mprosk/gameport/README.md

# GamePort to CV
KOSMO format module that converts a GamePort joystick to gate and control voltages

The X and Y movement of the stick is output as two independent control voltages ranging from 0V to +5V. The two buttons are output as gate signals, also from 0V to +5V
