mprosk/gameport/schematic.pdf

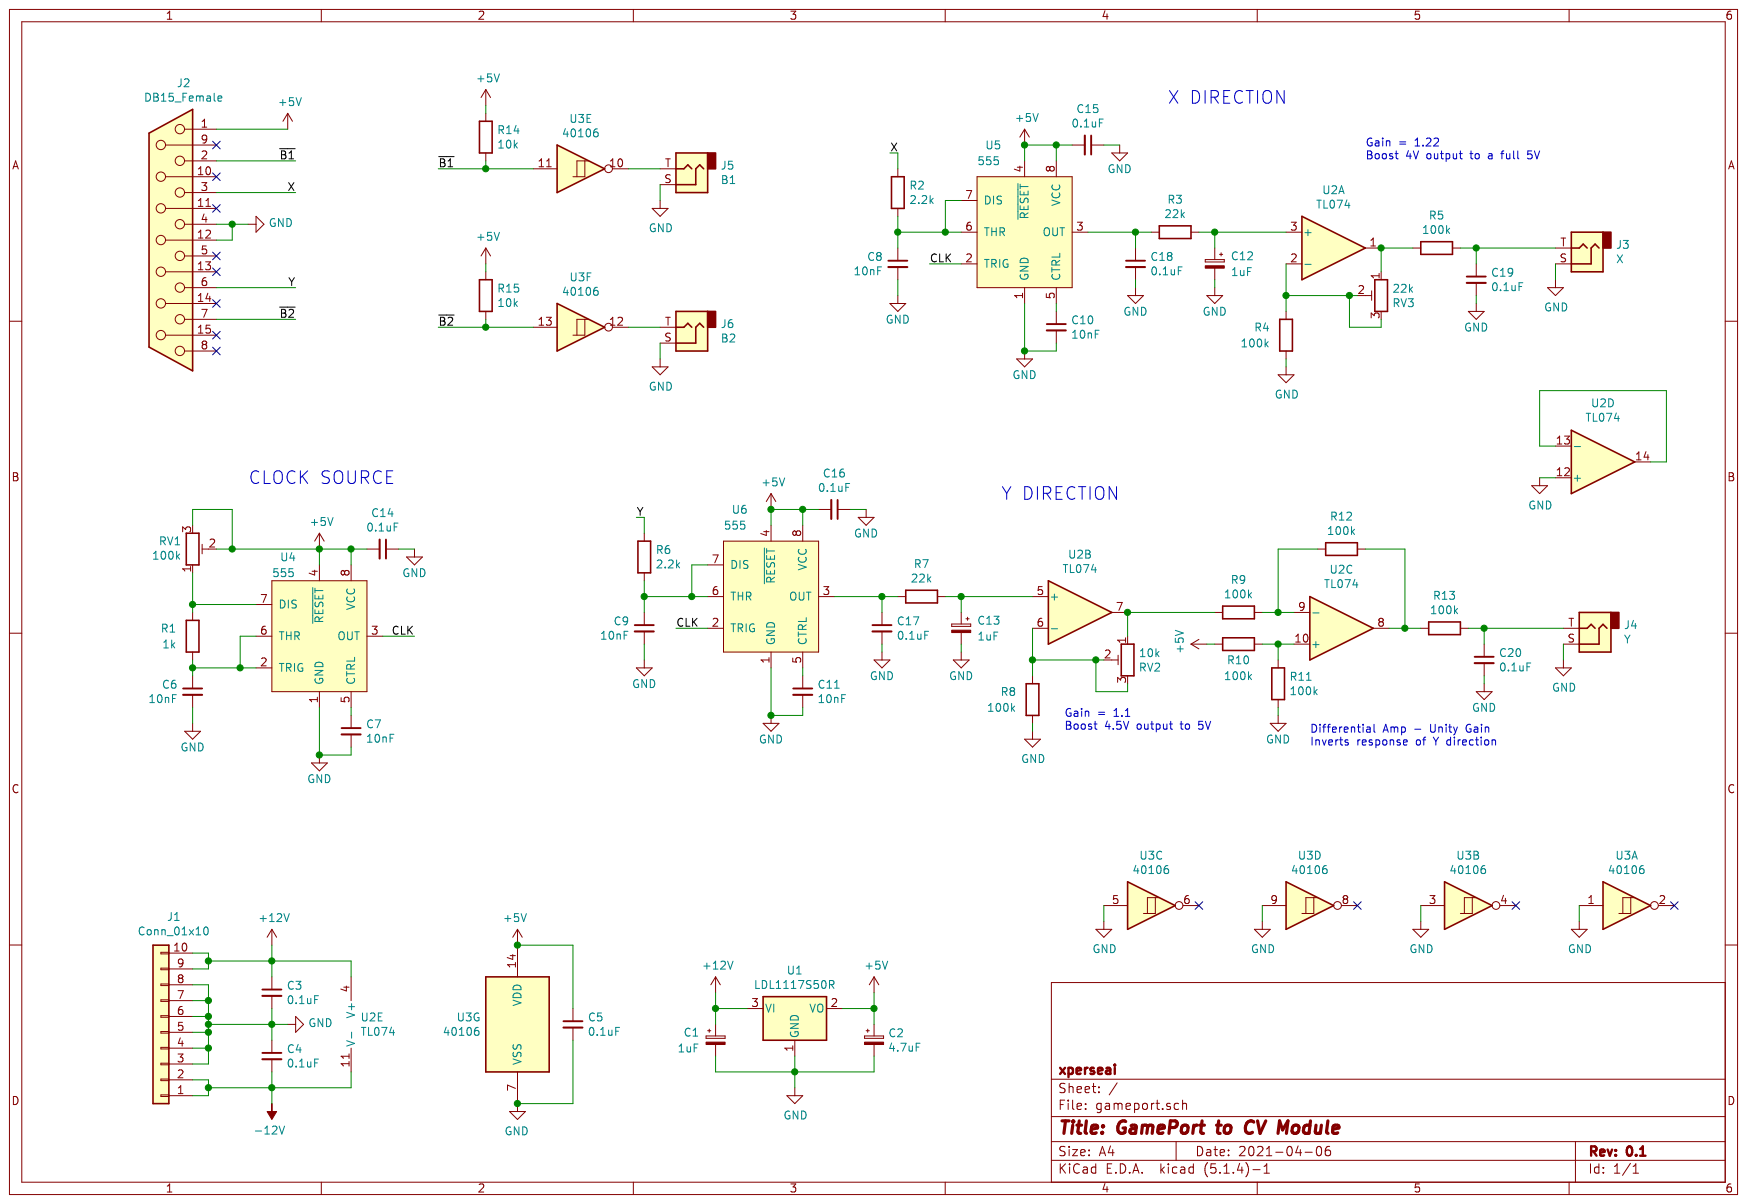
[picture p1: page 1]
