mprosk/gameport/gameport/y_axis_diff_amp.asc

R1: res; 100k
R2: res; 100k
R3: res; 100k
R4: res; 100k
U1: UniversalOpamp2
V1: voltage; 12
V2: voltage; -12
V3: voltage; 2
V4: voltage; 5
Named nets: 0, OUTPUT, INPUT
.dc V3 0 5 .1
