mprosk/gameport/gameport/gameport.kicad_pcb

## KiCad design gameport/gameport.kicad_pcb (2022-04-15)

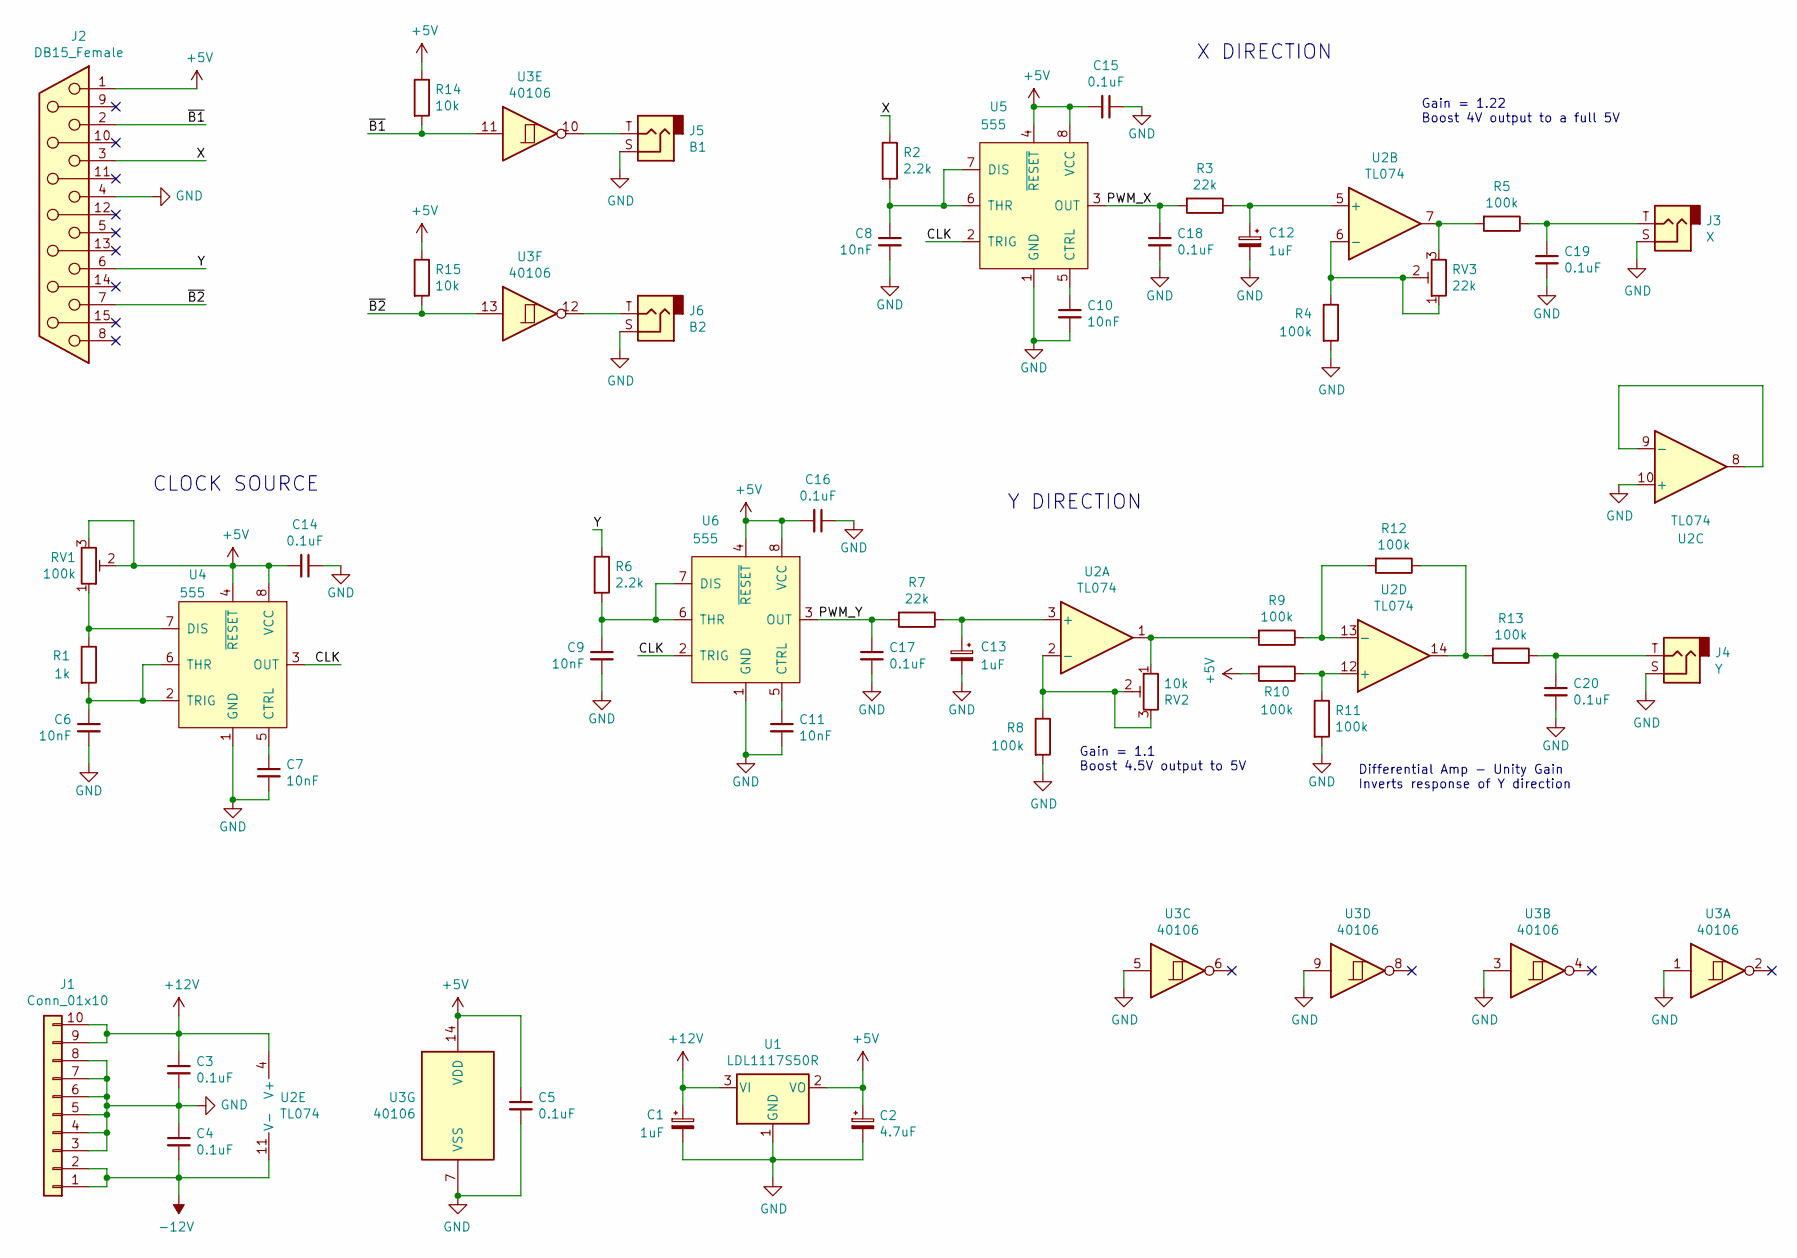
[picture p2: schematic gameport.kicad_sch, GamePort to CV Module]

Parts:
C1, C12, C13: 1uF; CP_Radial_D5.0mm_P2.00mm
C2: 4.7uF; CP_Radial_D5.0mm_P2.00mm
C3, C4, C5, C14, C15, C16, C17, C18, C19, C20: 0.1uF; C_Disc_D3.0mm_W1.6mm_P2.50mm
C6, C7, C8, C9, C10, C11: 10nF; C_Disc_D3.0mm_W1.6mm_P2.50mm
J1: Conn_01x10; IDC-Header_2x05_P2.54mm_Vertical
J2: DB15_Female; DSUB-15_Female_Horizontal_P2.77x2.84mm_EdgePinOffset4.94mm_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
J3: X; Molex_KK-254_AE-6410-02A_1x02_P2.54mm_Vertical
J4: Y; Molex_KK-254_AE-6410-02A_1x02_P2.54mm_Vertical
J5: B1; Molex_KK-254_AE-6410-02A_1x02_P2.54mm_Vertical
J6: B2; Molex_KK-254_AE-6410-02A_1x02_P2.54mm_Vertical
R1: 1k; R_Axial_DIN0207_L6.3mm_D2.5mm_P10.16mm_Horizontal
R2, R6: 2.2k; R_Axial_DIN0207_L6.3mm_D2.5mm_P10.16mm_Horizontal
R3, R7: 22k; R_Axial_DIN0207_L6.3mm_D2.5mm_P10.16mm_Horizontal
R4, R5, R8, R9, R10, R11, R12, R13: 100k; R_Axial_DIN0207_L6.3mm_D2.5mm_P10.16mm_Horizontal
R14, R15: 10k; R_Axial_DIN0207_L6.3mm_D2.5mm_P10.16mm_Horizontal
RV1: 100k; Potentiometer_Bourns_3296Y_Vertical
RV2: 10k; Potentiometer_Bourns_3296Y_Vertical
RV3: 22k; Potentiometer_Bourns_3296Y_Vertical
U1: LDL1117S50R; SOT-223-3_TabPin2
U2: TL074; DIP-14_W7.62mm
U3: 40106; DIP-14_W7.62mm
U4, U5, U6: 555; DIP-8_W7.62mm

Connections:
+5V: C2.1, C5.1, C14.2, C15.2, C16.2, J2.1, R10.2, R14.1, R15.1, RV1.2, RV1.3, U1.2 (VO), U3.14 (VDD), U4.4 (~RESET), U4.8 (VCC), U5.4 (~RESET), U5.8 (VCC), U6.4 (~RESET), U6.8 (VCC)
+12V: C1.1, C3.1, J1.9, J1.10, U1.3 (VI), U2.4 (V+)
-12V: C4.2, J1.1, J1.2, U2.11 (V-)
/CLK: U4.3 (OUT), U5.2 (TRIG), U6.2 (TRIG)
/PWM_X: C18.1, R3.2, U5.3 (OUT)
/PWM_Y: C17.1, R7.2, U6.3 (OUT)
/X: J2.3, R2.1
/Y: J2.6, R6.1
/~B1: J2.2, R14.2, U3.11
/~B2: J2.7, R15.2, U3.13
GND: C1.2, C2.2, C3.2, C4.1, C5.2, C6.2, C7.2, C8.2, C9.2, C10.2, C11.2, C12.2, C13.2, C14.1, C15.1, C16.1, C17.2, C18.2, C19.2, C20.2, J1.3, J1.4, J1.5, J1.6, J1.7, J1.8, J2.4, J3.S, J4.S, J5.S, J6.S, R4.2, R8.2, R11.2, U1.1 (GND), U2.10 (+), U3.1, U3.3, U3.5, U3.7 (VSS), U3.9, U4.1 (GND), U5.1 (GND), U6.1 (GND)
unnamed: C6.1, R1.2, U4.2 (TRIG), U4.6 (THR)
unnamed: C7.1, U4.5 (CTRL)
unnamed: C8.1, R2.2, U5.6 (THR), U5.7 (DIS)
unnamed: C9.1, R6.2, U6.6 (THR), U6.7 (DIS)
unnamed: C10.1, U5.5 (CTRL)
unnamed: C11.1, U6.5 (CTRL)
unnamed: C12.1, R3.1, U2.5 (+)
unnamed: C13.1, R7.1, U2.3 (+)
unnamed: C19.1, J3.T, R5.1
unnamed: C20.1, J4.T, R13.1
unnamed: J5.T, U3.10
unnamed: J6.T, U3.12
unnamed: R1.1, RV1.1, U4.7 (DIS)
unnamed: R4.1, RV3.1, RV3.2, U2.6 (-)
unnamed: R5.2, RV3.3, U2.7
unnamed: R8.1, RV2.2, RV2.3, U2.2 (-)
unnamed: R9.2, RV2.1, U2.1
unnamed: R10.1, R11.1, U2.12 (+)
unnamed: R12.1, R13.2, U2.14
unnamed: R9.1, R12.2, U2.13 (-)
unnamed: U2.8, U2.9 (-)

Notes on the sheet:
CLOCK SOURCE
Gain = 1.22 Boost 4V output to a full 5V
Y DIRECTION
X DIRECTION
Gain = 1.1 Boost 4.5V output to 5V
Differential Amp - Unity Gain Inverts response of Y direction

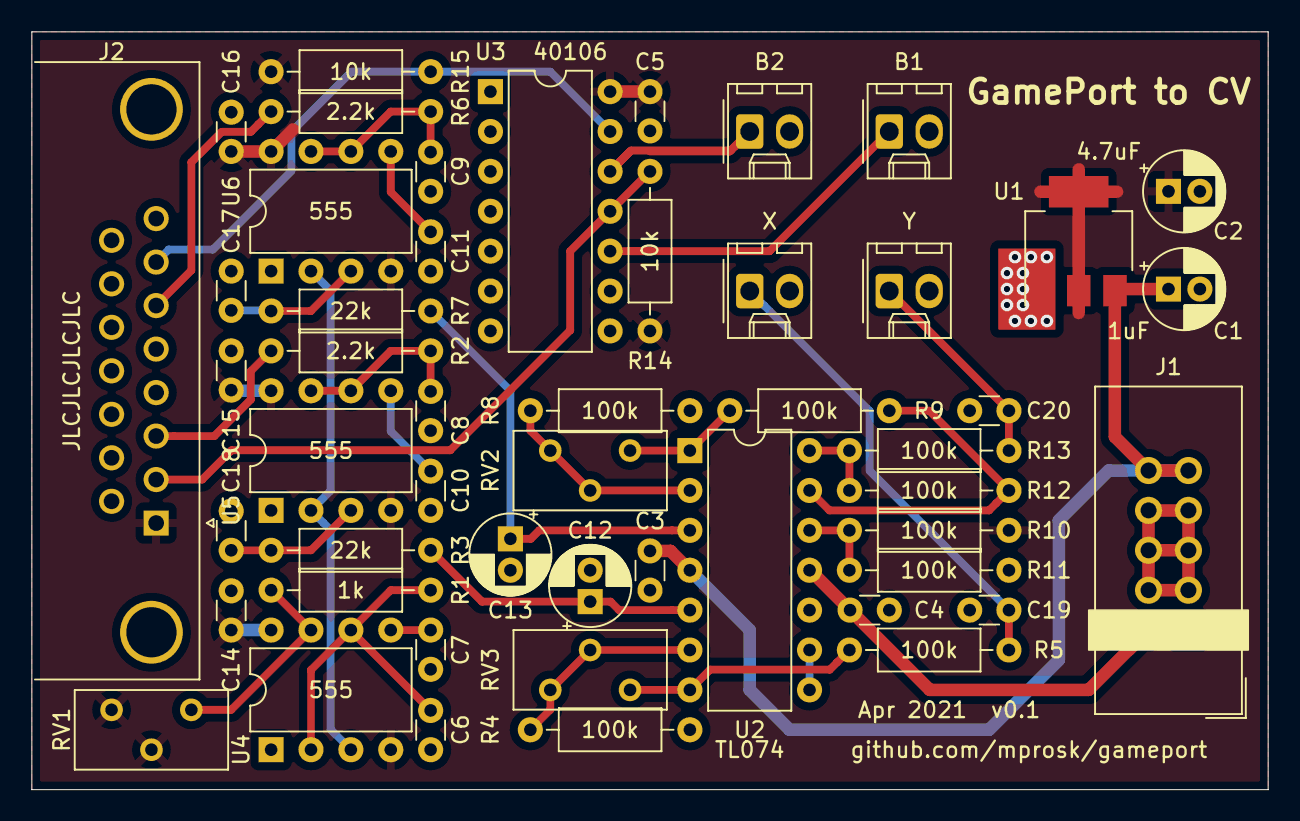
[picture p3: board gameport.kicad_pcb from above]

Board: 2 copper layers, 78.7 x 48.3 mm, 50 parts (0 on the bottom side), 32 nets.
