mprosk/gameport/(commit log)

2021-04-05 add files from other repo
    [gameport.kicad_pcb, gameport.sch, gameport_faceplate.kicad_pcb, gameport_faceplate.sch, joystick.kicad_pcb, joystick.sch]
2021-04-07 Update schematic
    [gameport.sch]
2021-04-07 Complete layout
    [gameport.kicad_pcb, gameport.sch]
2021-04-08 Complete faceplate
    [gameport_faceplate.kicad_pcb]
2021-04-22 Update faceplate
    [gameport_faceplate.kicad_pcb]
2022-04-15 Update to Kicad6. Use kosmo-lib submodule
    [gameport.kicad_pcb, gameport.kicad_sch, gameport.sch, gameport_faceplate.kicad_pcb, gameport_faceplate.kicad_sch, gameport_faceplate.sch]
